victorhook/F1C200S-Dev-board/F1C200S-Dev-board/F1C200S-Dev-board.pdf

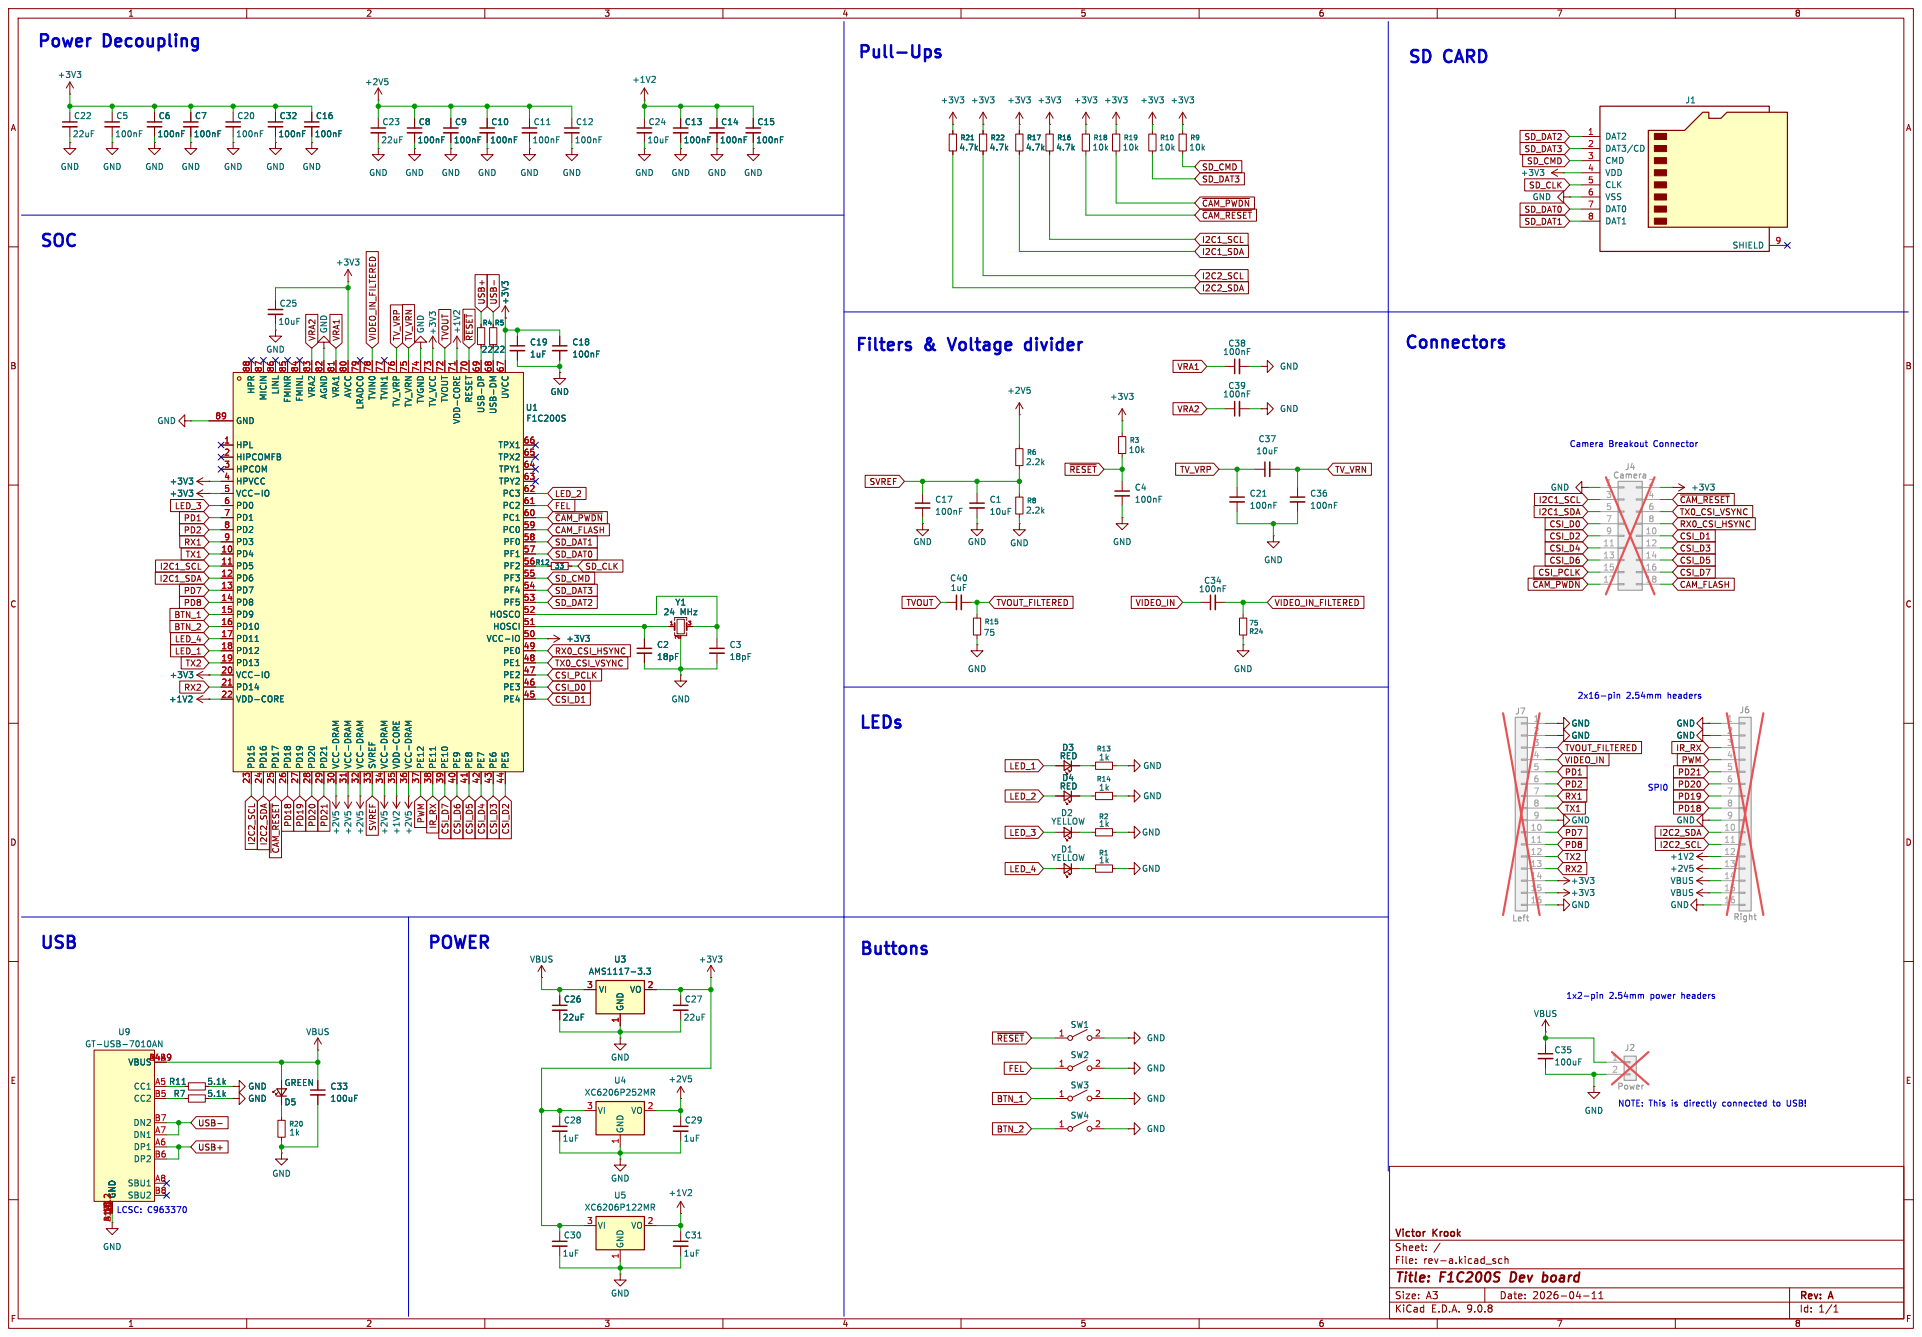
[picture p3: page 1]

Camera Breakout Connector Buttons POWER

GND GND

Id: 1/1 Title: F1C200S Dev board
