victorhook/F1C200S-Dev-board/F1C200S-Dev-board/F1C200S-Dev-board.kicad_pcb

## KiCad design F1C200S-Dev-board/F1C200S-Dev-board.kicad_pcb (2026-04-12)

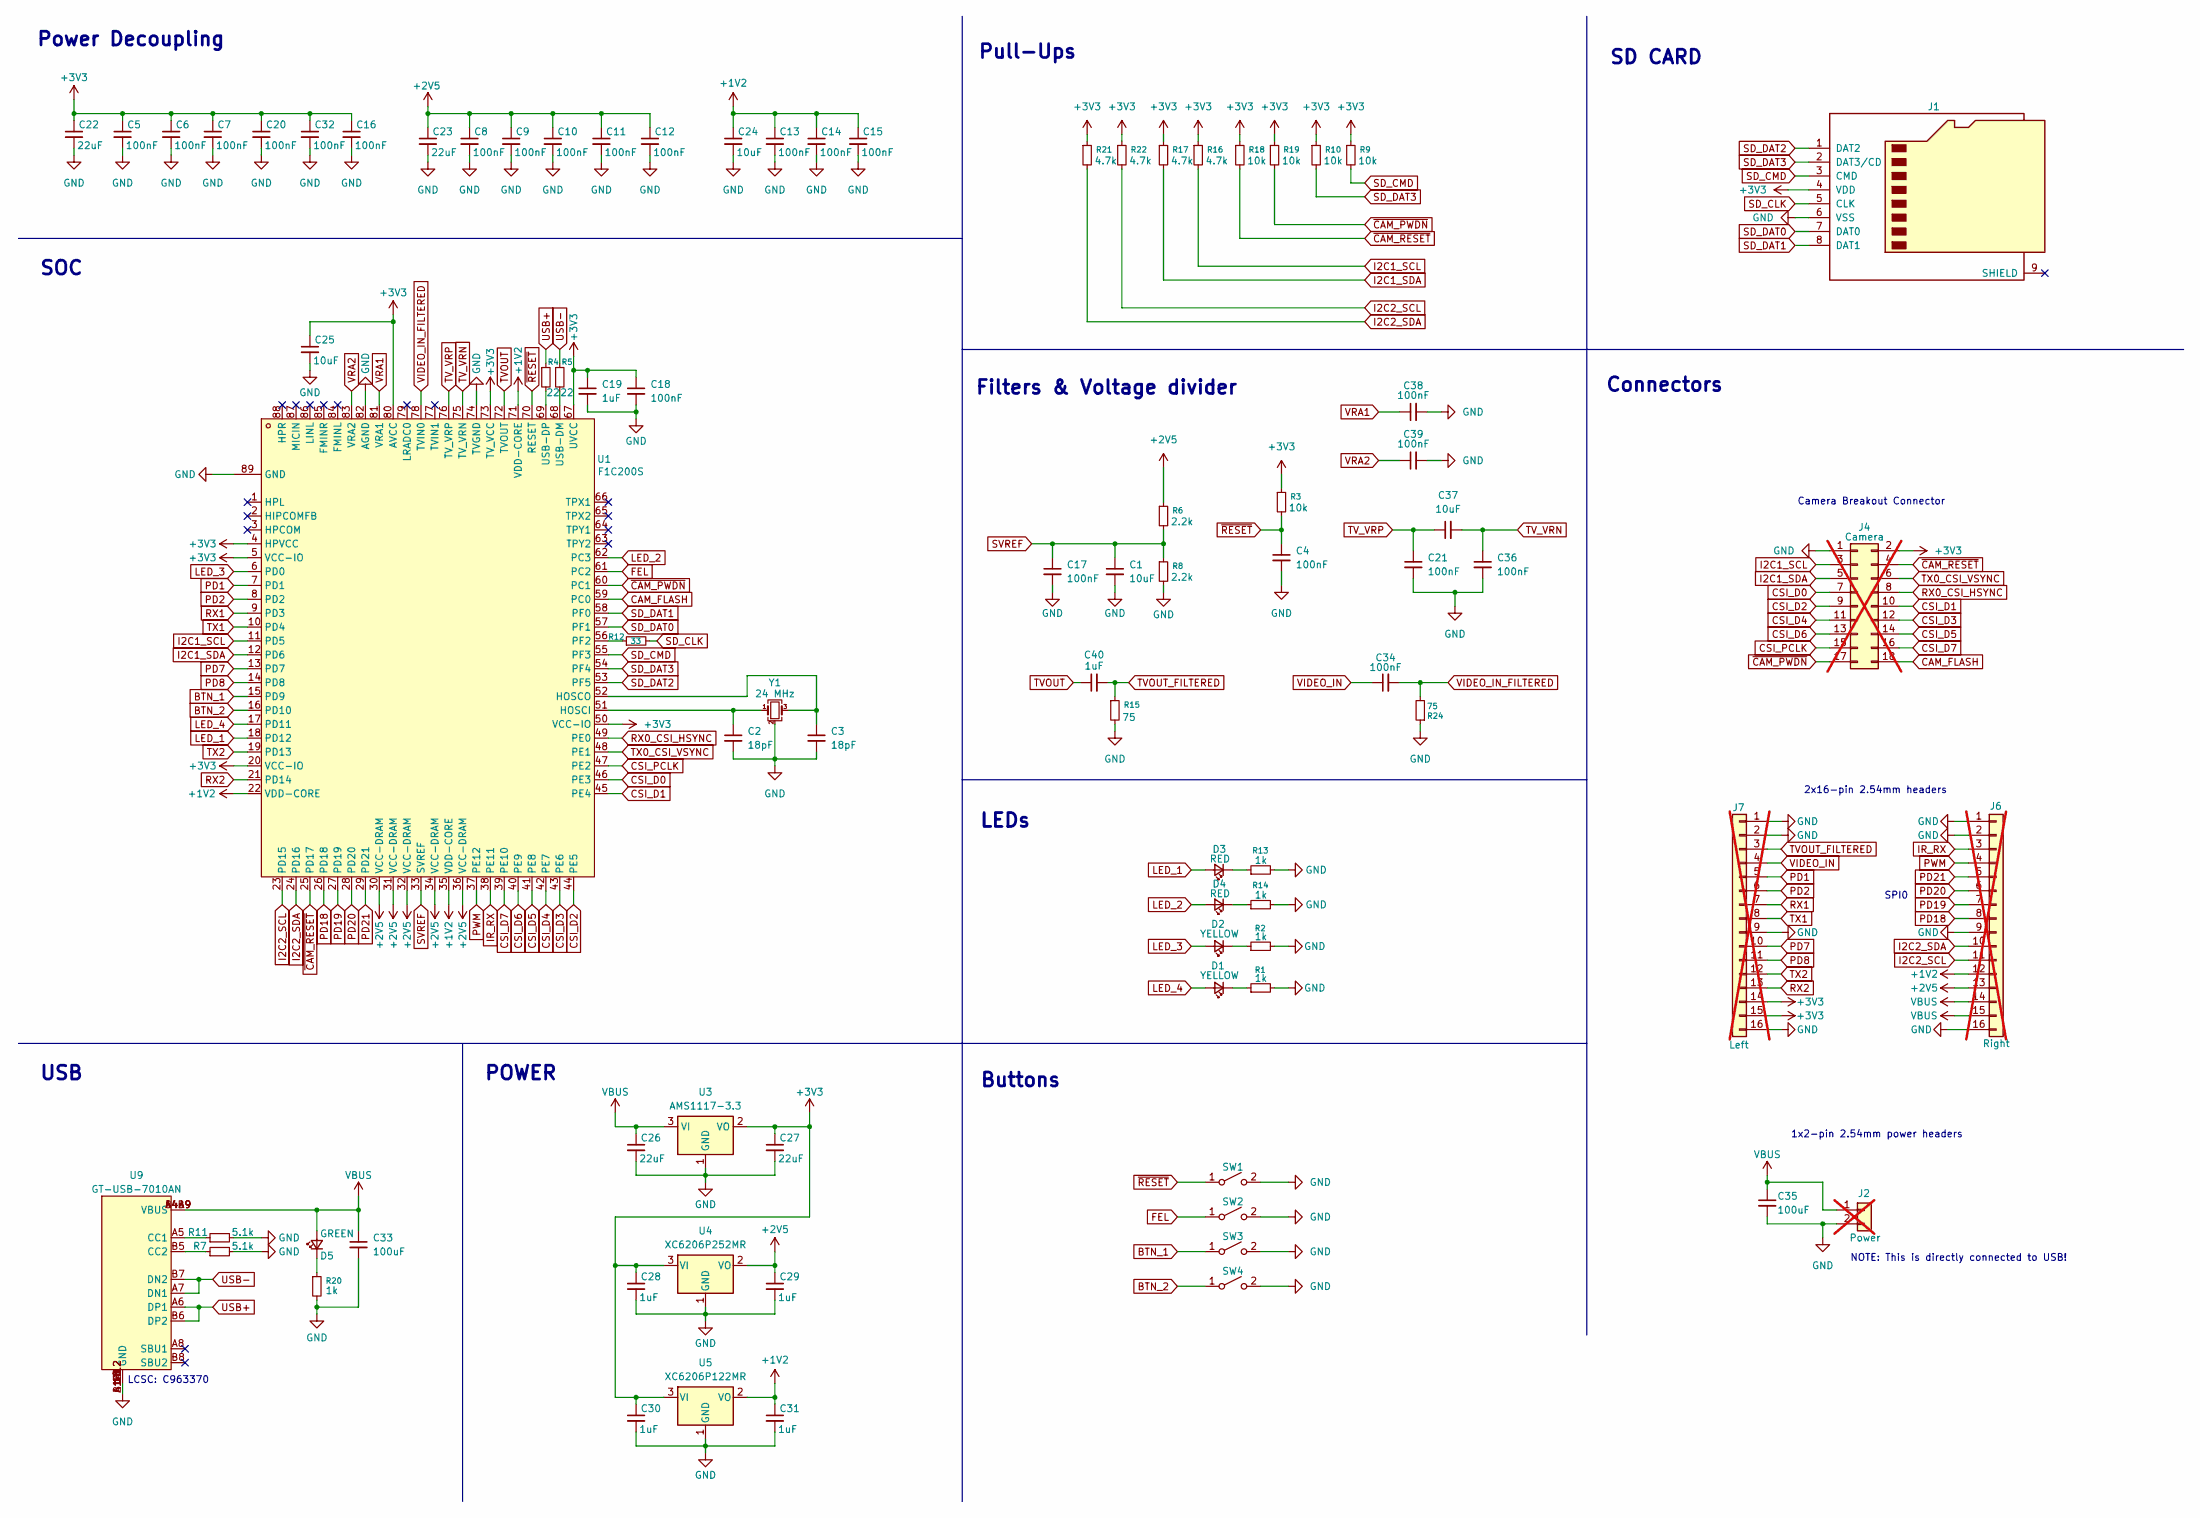
[picture p4: schematic F1C200S-Dev-board.kicad_sch, F1C200S Dev board]

Parts:
C1, C24, C25: 10uF; C_0603_1608Metric
C2, C3: 18pF; C_0402_1005Metric; LCSC Part C1549
C4, C5, C6, C7, C8, C9, C10, C11, C12, C13, C14, C15, C16, C17, C18, C20, C21, C32, C34, C36, C38, C39: 100nF; C_0402_1005Metric
C19, C40: 1uF; C_0402_1005Metric
C22, C23, C26, C27: 22uF; C_0603_1608Metric
C28, C29, C30, C31: 1uF; C_0603_1608Metric
C33, C35: 100uF; C_1206_3216Metric; LCSC Part C15008
C37: 10uF; C_0402_1005Metric
D1, D2: YELLOW; LED_0603_1608Metric; LCSC Part C2290
D3, D4: RED; LED_0603_1608Metric; LCSC Part C2286
D5: GREEN; LED_0805_2012Metric; LCSC Part C2297
J1: Micro_SD_Card; TF-SMD_TF-021B-H265; LCSC Part C498185
J2: Power; PinSocket_1x02_P2.54mm_Vertical; not fitted
J4: Camera; PinSocket_2x09_P2.54mm_Vertical; not fitted
J6: Right; PinSocket_1x16_P2.54mm_Vertical; not fitted
J7: Left; PinSocket_1x16_P2.54mm_Vertical; not fitted
R1, R2, R13, R14, R20: 1k; R_0402_1005Metric
R3, R9, R10, R18, R19: 10k; R_0402_1005Metric
R4, R5: 22; R_0402_1005Metric; LCSC Part C25092
R6, R8: 2.2k; R_0402_1005Metric
R7, R11: 5.1k; R_0402_1005Metric
R12: 33; R_0402_1005Metric; LCSC Part C25105
R15, R24: 75; R_0603_1608Metric; LCSC Part C4275
R16, R17, R21, R22: 4.7k; R_0402_1005Metric
SW1, SW2, SW3, SW4: SW_SPST; SW-SMD_L3.9-W3.0-P4.45; LCSC Part C720477
U1: F1C200S; QFN-88_L10.0-W10.0-P0.40-BL-EP6.75; LCSC Part C2879851
U3: AMS1117-3.3; SOT-223-3_TabPin2; LCSC Part C6186
U4: XC6206P252MR; SOT-23-3; LCSC Part C15906
U5: XC6206P122MR; SOT-23-3; LCSC Part C424699
U9: GT-USB-7010AN; USB-SMD_GT-USB-7010AN; LCSC Part C963370
Y1: 24 MHz; Crystal_SMD_3225-4Pin_3.2x2.5mm; LCSC Part C37635376

Connections:
+1V2: C13.1, C14.1, C15.1, C24.1, C31.1, J6.12, U1.22 (VDD-CORE), U1.35 (VDD-CORE), U1.71 (VDD-CORE), U5.2 (VO)
+2V5: C8.1, C9.1, C10.1, C11.1, C12.1, C23.1, C29.1, J6.13, R6.1, U1.30 (VCC-DRAM), U1.31 (VCC-DRAM), U1.32 (VCC-DRAM), U1.34 (VCC-DRAM), U1.36 (VCC-DRAM), U4.2 (VO)
+3V3: C5.1, C6.1, C7.1, C16.1, C18.1, C19.1, C20.1, C22.1, C25.1, C27.1, C28.1, C30.1, C32.1, J1.4 (VDD), J4.2, J7.14, J7.15, R3.1, R9.1, R10.1, R16.1, R17.1, R18.1, R19.1, R21.1, R22.1, U1.4 (HPVCC), U1.5 (VCC-IO), U1.20 (VCC-IO), U1.50 (VCC-IO), U1.67 (UVCC), U1.73 (TV_VCC), U1.80 (AVCC), U3.2 (VO), U4.3 (VI), U5.3 (VI)
BTN_1: SW3.1 (A), U1.15 (PD9)
BTN_2: SW4.1 (A), U1.16 (PD10)
CAM_FLASH: J4.18, U1.59 (PC0)
CSI_D0: J4.7, U1.46 (PE3)
CSI_D1: J4.10, U1.45 (PE4)
CSI_D2: J4.9, U1.44 (PE5)
CSI_D3: J4.12, U1.43 (PE6)
CSI_D4: J4.11, U1.42 (PE7)
CSI_D5: J4.14, U1.41 (PE8)
CSI_D6: J4.13, U1.40 (PE9)
CSI_D7: J4.16, U1.39 (PE10)
CSI_PCLK: J4.15, U1.47 (PE2)
FEL: SW2.1 (A), U1.61 (PC2)
GND: C1.2, C2.2, C3.2, C4.2, C5.2, C6.2, C7.2, C8.2, C9.2, C10.2, C11.2, C12.2, C13.2, C14.2, C15.2, C16.2, C17.2, C18.2, C19.2, C20.2, C21.2, C22.2, C23.2, C24.2, C25.2, C26.2, C27.2, C28.2, C29.2, C30.2, C31.2, C32.2, C33.2, C35.2, C36.2, C38.2, C39.2, J1.6 (VSS), J2.2, J4.1, J6.1, J6.2, J6.9, J6.16, J7.1, J7.2, J7.9, J7.16, R1.2, R2.2, R7.2, R8.2, R11.2, R13.2, R14.2, R15.2, R20.2, R24.1, SW1.2 (B), SW2.2 (B), SW3.2 (B), SW4.2 (B), U1.74 (TVGND), U1.82 (AGND), U1.89 (GND), U3.1 (GND), U4.1 (GND), U5.1 (GND), U9.13 (GND), U9.14 (GND), U9.15 (GND), U9.16 (GND), U9.A1B12 (GND), U9.B1A12 (GND), Y1.2 (G), Y1.4 (G)
I2C1_SCL: J4.3, R16.2, U1.11 (PD5)
I2C1_SDA: J4.5, R17.2, U1.12 (PD6)
I2C2_SCL: J6.11, R22.2, U1.23 (PD15)
I2C2_SDA: J6.10, R21.2, U1.24 (PD16)
IR_RX: J6.3, U1.38 (PE11)
LED_1: D3.2 (A), U1.18 (PD12)
LED_2: D4.2 (A), U1.62 (PC3)
LED_3: D2.2 (A), U1.6 (PD0)
LED_4: D1.2 (A), U1.17 (PD11)
unnamed: D1.1 (K), R1.1
unnamed: D2.1 (K), R2.1
unnamed: D3.1 (K), R13.1
unnamed: D4.1 (K), R14.1
unnamed: D5.1 (K), R20.1
unnamed: C2.1, U1.51 (HOSCI), Y1.1
unnamed: C3.1, U1.52 (HOSCO), Y1.3
unnamed: R12.1, U1.56 (PF2)
unnamed: R5.2, U1.68 (USB-DM)
unnamed: R4.2, U1.69 (USB-DP)
unnamed: R11.1, U9.A5 (CC1)
unnamed: R7.1, U9.B5 (CC2)
PD1: J7.5, U1.7 (PD1)
PD2: J7.6, U1.8 (PD2)
PD7: J7.10, U1.13 (PD7)
PD8: J7.11, U1.14 (PD8)
PD18: J6.8, U1.26 (PD18)
PD19: J6.7, U1.27 (PD19)
PD20: J6.6, U1.28 (PD20)
PD21: J6.5, U1.29 (PD21)
PWM: J6.4, U1.37 (PE12)
RX0_CSI_HSYNC: J4.8, U1.49 (PE0)
RX1: J7.7, U1.9 (PD3)
RX2: J7.13, U1.21 (PD14)
SD_CLK: J1.5 (CLK), R12.2
SD_CMD: J1.3 (CMD), R9.2, U1.55 (PF3)
SD_DAT0: J1.7 (DAT0), U1.57 (PF1)
SD_DAT1: J1.8 (DAT1), U1.58 (PF0)
SD_DAT2: J1.1 (DAT2), U1.53 (PF5)
SD_DAT3: J1.2 (DAT3/CD), R10.2, U1.54 (PF4)
SVREF: C1.1, C17.1, R6.2, R8.1, U1.33 (SVREF)
TVOUT: C40.1, U1.72 (TVOUT)
TVOUT_FILTERED: C40.2, J7.3, R15.1
TV_VRN: C36.1, C37.2, U1.75 (TV_VRN)
TV_VRP: C21.1, C37.1, U1.76 (TV_VRP)
TX0_CSI_VSYNC: J4.6, U1.48 (PE1)
TX1: J7.8, U1.10 (PD4)
TX2: J7.12, U1.19 (PD13)
USB+: R4.1, U9.A6 (DP1), U9.B6 (DP2)
USB-: R5.1, U9.A7 (DN1), U9.B7 (DN2)
VBUS: C26.1, C33.1, C35.1, D5.2 (A), J2.1, J6.14, J6.15, U3.3 (VI), U9.A4B9 (VBUS), U9.B4A9 (VBUS)
VIDEO_IN: C34.1, J7.4
VIDEO_IN_FILTERED: C34.2, R24.2, U1.78 (TVIN0)
VRA1: C38.1, U1.81 (VRA1)
VRA2: C39.1, U1.83 (VRA2)
~CAM_PWDN: J4.17, R19.2, U1.60 (PC1)
~CAM_RESET: J4.4, R18.2, U1.25 (PD17)
~RESET: C4.1, R3.2, SW1.1 (A), U1.70 (RESET)

Notes on the sheet:
Power Decoupling
2x16-pin 2.54mm headers
Connectors
Buttons
Filters & Voltage divider
SD CARD
1x2-pin 2.54mm power headers
LEDs
SOC
Pull-Ups
USB
Camera Breakout Connector
NOTE: This is directly connected to USB!
SPI0
LCSC: C963370
POWER

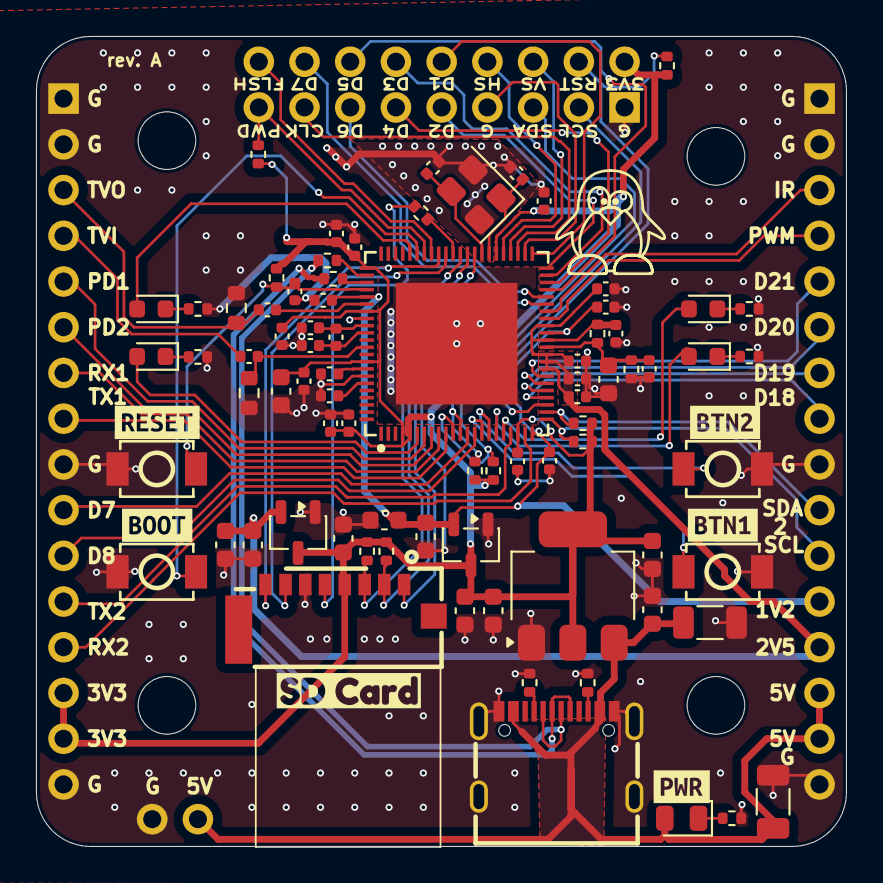
[picture p5: board F1C200S-Dev-board.kicad_pcb from above]

Board: 2 copper layers, 45.0 x 45.0 mm, 89 parts (0 on the bottom side), 74 nets.

Other parts of the board:
kibuzzard-67EE0EFE: G***; kibuzzard-67EE0EFE
kibuzzard-69D20BF5: G***; kibuzzard-69D20BF5
kibuzzard-69D21EBA: G***; kibuzzard-69D21EBA
kibuzzard-69D21EC5: G***; kibuzzard-69D21EC5
kibuzzard-69D21F31: G***; kibuzzard-69D21F31
kibuzzard-69D21F51: G***; kibuzzard-69D21F51
