victorhook/F1C200S-Dev-board/(commit log)

2026-04-20 Rev A Linux bring-up: boot to busybox shell on 2026-04-20
    The Rev A boards arrived and reached a root shell on UART0 under
    Linux 6.19.11. Core path validated: USB-C power, DDR1, 24MHz PLL,
    MMC, pinctrl, UART, GPIO LEDs, SPI (PIO fallback), gpio-keys.
    Key fixes:
    - kernel defconfig: "sunxi" is ARMv7 (Cortex-A family) -- the F1C200S
    is ARM926EJ-S (ARMv5TE). Switched to multi_v5. Without this the
    decompressor ran but the decompressed kernel silently died at the
    first ARMv7-only instruction.
    - DTS: enable &otg_sram (required by MUSB on suniv), remove the
    touchscreen stub that lacked clock bindings, add button-2 (PD10),
    disable the ST7735 panel node until the display is wired,
    conser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
2026-04-20 USB composite gadget + buttons + UMS: one cable does it all
    Builds on yesterday's first-boot milestone: now a single USB-C cable to
    the host provides power, a console on /dev/ttyACM0, and a network link
    on usb0 (192.168.100.1). GPIO buttons are now usable via the input
    subsystem. No more SD card yanks for most iterations going forward.
    Kernel patch
    - br2-external/board/f1c200s-devboard/linux-patches/0001-pinctrl-suniv-f1c100s-disable-strict-pinmux.patch
    aligns suniv's pinctrl strict-mode behaviour with sun4i-a10,
    sun8i-a33, etc. Without it, gpio-keys fails at probe because the
    pinctrl default state claims PD9/PD10 with the gpio_in mux function
    before gpio-keys re-requests them as GP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
2026-04-21 Stabilize bring-up: gadget race fix, cleanups, per-app src/ structure
    USB composite gadget race
    - rcS was launching getty on /dev/ttyGS0 immediately after binding the
    gadget, but that device does not exist until the host enumerates --
    getty exited silently, leaving the CDC serial unresponsive on the
    board side while still visible on the host.
    - Moved the shell onto ttyGS0 via inittab (`ttyGS0::respawn:-/bin/sh`).
    init respawns until the device appears, and keeps it alive across
    plug/unplug cycles.
    - Dropped the dead setsid/getty invocation from rcS.
    U-Boot DTS
    - dr_mode = "peripheral" to match the Linux DTS. With "otg" and no
    ID-detect GPIO wired, MUSB never registered a UDC, so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
    [main.c]
2026-04-22 dts: enable ST7735 display with inverted RST polarity
    Wired up the jianda jd-t18003-t01 panel this session. Two changes:
    - status = "okay" — panel is physically connected now.
    - reset-gpios flipped from GPIO_ACTIVE_LOW to GPIO_ACTIVE_HIGH. The
    datasheet-correct polarity for the ST7735 controller is active-low,
    but on this particular module the chip's reset line appears to be
    inverted relative to the header pin (probably a small logic
    inverter on the PCB, or clone wiring). Symptom with active-low:
    /dev/fb0 comes up and cat /dev/urandom > /dev/fb0 "succeeds", but
    the panel stays pure white because the controller is held
    permanently in reset; /sys/kernel/debug/gpio showed "out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
2026-04-24 camera: bare-metal capture path working on OV2640
    First real photo on 2026-04-24. sun4i-csi's YUV420-planar hardware
    path produces a 1:4 byte pattern on suniv (only 160 of 640 bytes per
    line land in DRAM); RAW passthrough bypasses the broken converter and
    captures clean full-res YUYV straight from the DVP bus.
    Known-good reference:
    modules/csi-buf/ DMA-coherent buffer exposed as /dev/csi-buf,
    no mem= bootarg required
    src/csi-capture/ takes CSI over via /dev/mem, reprograms for
    RAW passthrough, captures one frame
    tools/decode-uyvy.py host-side YUYV -> PGM with percentile
    contrast stretching
    tools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
    [main.c]
2026-04-25 camera: ship the real fix via packed-format driver path + tooling polish
    The mainline sun4i-csi driver's YUV420-planar pipeline is broken on
    suniv F1C100S/F1C200S — it routes the DVP byte stream through a
    hardware YUV422->YUV420 conversion block that captures roughly 1 in 4
    bytes per line (we proved this with both the LA capture and the
    csi-regs/csi-poke tools). RAW passthrough mode bypasses that broken
    block entirely and DMAs the byte stream straight to DRAM, which is
    what our bare-metal csi-capture uses to grab clean frames.
    This commit lifts that working approach into the kernel driver so the
    normal V4L2 path (yavta + /dev/video0) just works — no /dev/mem, no
    csi-capture/csi-buf shu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
